AI-FanGe/AI_DesktopCat_Qwen3.5Omni/upload_facial_expression/README.md

# XIAO ESP32S3 全模块综合测试程序

## 📋 功能说明

这是一个综合测试固件，用于验证所有模块的功能。

---

## 🎬 新功能：动画播放

支持从8MB Flash读取JPEG序列帧动画并播放到屏幕上。使用PSRAM进行缓存。

### 动画文件说明
| 文件夹 | 帧数 | 文件名格式 |
|---|---|---|
| `anim1/` | 182帧 | 0001.jpg - 0182.jpg |
| `anim2/` | 35帧 | 0001.jpg - 0035.jpg |
| `anim3/` | 166帧 | 0001.jpg - 0166.jpg |

### 动画播放命令

| 命令 | 功能 |
|---|---|
| `a1` | 播放动画1 (182帧) |
| `a2` | 播放动画2 (35帧) |
| `a3` | 播放动画3 (166帧) |
| `a0` | 停止动画 |
| `al` | 切换循环模式 |

### ⚡ 上传动画数据到Flash

#### 方法1：使用Arduino IDE LittleFS插件（推荐）

1. **安装ESP32 LittleFS上传插件**
   - 下载插件：https://github.com/lorol/arduino-esp32littlefs-plugin/releases
   - 解压后将 `ESP32LittleFS` 文件夹放入 `Arduino/tools/` 目录
   - 最终路径应为：`Arduino/tools/ESP32LittleFS/tool/esp32littlefs.jar`
   - 重启Arduino IDE

2. **配置分区表**
   - Arduino IDE -> 工具 -> Partition Scheme
   - 选择 **"8M with spiffs (3MB APP/1.5MB SPIFFS)"**
   - 或选择自定义分区以获得更大存储空间

3. **准备data文件夹**
   - 确保 `data` 文件夹与 `test_all_modules.ino` 在同一目录
   ```
   test_all_modules/
   ├── test_all_modules.ino
   └── data/
       ├── anim1/
       │   ├── 0001.jpg
       │   ├── 0002.jpg
       │   └── ...
       ├── anim2/
       │   └── ...
       └── anim3/
           └── ...
   ```

4. **上传data文件夹**
   - Arduino IDE -> 工具 -> ESP32 Sketch Data Upload
   - 等待上传完成（可能需要几分钟）

#### 方法2：使用 esptool.py 命令行

```bash
# 1. 安装 mklittlefs 工具
# Windows: 从 https://github.com/earlephilhower/mklittlefs/releases 下载

# 2. 创建LittleFS镜像 (根据分区大小调整 -s 参数)
mklittlefs -c data -b 4096 -p 256 -s 3145728 littlefs.bin

# 3. 上传到ESP32S3 (根据实际COM端口和分区偏移地址修改)
esptool.py --chip esp32s3 --port COM3 --baud 921600 write_flash 0x290000 littlefs.bin
```

#### 方法3：使用 PlatformIO

在 `platformio.ini` 中配置：
```ini
[env:esp32s3]
platform = espressif32
board = seeed_xiao_esp32s3
framework = arduino
board_build.filesystem = littlefs
board_build.partitions = default_8MB.csv

# 启用PSRAM
build_flags = 
    -DBOARD_HAS_PSRAM
    -mfix-esp32-psram-cache-issue
```

然后运行：
```bash
pio run --target uploadfs
```

### 📚 需要安装的库

动画播放功能需要额外安装 **JPEGDEC** 库：
- Arduino IDE -> 工具 -> 管理库
- 搜索 `JPEGDEC` (作者: Larry Bank)
- 点击安装

### 🖼️ 图片格式要求

- 格式：JPEG
- 分辨率：建议 170x320 (与屏幕匹配) 或更小
- 单张大小：建议 < 60KB
- 命名：4位数字，如 0001.jpg, 0002.jpg

---

## 🔌 硬件连接

### 完整接线表

```
模块          引脚       ESP32S3
━━━━━━━━━━━━━━━━━━━━━━━━━━━━━
ST7789        CS      -> D0
屏幕          DC      -> D1
              RST     -> D2
              SDA     -> D10
              SCL     -> D8
              BL      -> VCC
              VCC     -> 3.3V
              GND     -> GND

PCA9685       SDA     -> D4
(I2C)         SCL     -> D5
              VCC     -> 3.3V或5V
              V+      -> 外部6V (舵机电源)
              GND     -> GND

MAX98357A     BCLK    -> D11 (底部焊盘)
(I2S音频)     LRC     -> D12 (底部焊盘)
              DIN     -> D9
              VCC     -> 5V
              GND     -> GND

URT-1         TX      -> D6
(总线舵机)    RX      -> D7
              VCC     -> 外部6-12V
              GND     -> GND
```

### ⚠️ 重要提示

1. **底部焊盘 D11/D12**
   - 需要在电路板背面焊接引线
   - 这两个引脚对应 GPIO42/GPIO41
   - 不与摄像头冲突

2. **电源共地**
   - 所有模块的 GND 必须连接在一起
   - PCA9685 的 V+ 使用外部电源（舵机供电）
   - URT-1 使用外部电源（总线舵机供电）

3. **URT-1 舵机 ID**
   - 测试前需将三个总线舵机 ID 分别设置为 **1、2、3**
   - 或修改代码中的 ID 号

## 🚀 使用方法

### 1. 上传程序

```bash
1. Arduino IDE 中打开 test_all_modules.ino
2. 选择板子: XIAO_ESP32S3
3. 选择端口
4. 点击上传
```

### 2. 打开串口监视器

```
波特率: 115200
```

### 3. 测试命令

在串口监视器中输入数字：

| 命令 | 功能 | 说明 |
|---|---|---|
| **1** | 屏幕测试 | 红→绿→蓝循环，每秒切换 |
| **2** | PCA9685测试 | 0和1号舵机交替旋转 |
| **3** | 音频测试 | 播放三个音调 (A-C-E) |
| **4** | URT-1测试 | 1/2/3号舵机同时来回旋转 |
| **5** | 全部测试 | 所有功能同时运行 |
| **0** | 停止 | 停止所有测试 |

## 📊 测试项目详情

### 测试1: 屏幕 (ST7789)

**测试内容:**
- 全屏填充红色 (1秒)
- 全屏填充绿色 (1秒)
- 全屏填充蓝色 (1秒)
- 循环

**通过标准:**
- ✓ 屏幕清晰显示三种颜色
- ✓ 颜色纯正无杂色
- ✓ 切换流畅无闪烁

### 测试2: PCA9685 舵机驱动

**测试内容:**
- 0号舵机：0° ↔ 90° 交替
- 1号舵机：90° ↔ 0° 交替
- 每秒切换一次

**通过标准:**
- ✓ 两个舵机都能旋转
- ✓ 角度准确
- ✓ 运动平滑

**连接舵机:**
```
舵机信号线 -> PCA9685 PWM0/PWM1
舵机电源 -> V+ (外部6V)
舵机GND -> GND
```

### 测试3: MAX98357A 音频

**测试内容:**
- 播放 440Hz 音调 (A音，200ms)
- 播放 523Hz 音调 (C音，200ms)  
- 播放 659Hz 音调 (E音，200ms)

**通过标准:**
- ✓ 能听到三个清晰的音调
- ✓ 音调不同（低→中→高）
- ✓ 无杂音或爆音

**连接扬声器:**
```
MAX98357A -> 扬声器
+  -> 扬声器+
-  -> 扬声器-
```

### 测试4: URT-1 总线舵机

**测试内容:**
- ID为1、2、3的三个舵机同时移动到位置500（约60°）
- 等待2秒
- 三个舵机同时移动到位置200（约24°）
- 等待2秒
- 循环

**通过标准:**
- ✓ 三个舵机都能收到命令
- ✓ 舵机同步来回旋转
- ✓ 位置准确

**舵机设置:**
- 使用 LX-16A 或兼容的总线舵机
- 将三个舵机 ID 分别设置为 **1、2、3**
- 或修改代码中的 ID

### 测试5: 全部同时运行

**测试内容:**
- 屏幕颜色循环（每1秒）
- PCA舵机交替（每1秒）
- 音频嘀嘀声（每3秒）
- URT-1舵机旋转（每2秒）

**通过标准:**
- ✓ 所有功能都能正常工作
- ✓ 没有相互干扰
- ✓ 系统稳定不死机

## 🔧 故障排除

### 问题1: 屏幕不显示

**检查:**
- CS, DC, RST, SDA, SCL 连接是否正确
- VCC 是否有 3.3V
- BL 背光是否接 VCC

**解决:**
- 参考之前的 test_basic.ino 测试

### 问题2: PCA9685 舵机不动

**检查:**
- I2C 连接 (SDA-D4, SCL-D5)
- V+ 外部电源是否连接（6V）
- 舵机信号线是否接对通道

**测试:**
- 串口应显示 "✓ PCA9685初始化完成"
- 舵机应该有"哒哒"声

### 问题3: 音频无声

**检查:**
- D11/D12 底部引脚是否焊接
- MAX98357A 电源是否正常
- 扬声器是否连接

**常见原因:**
- D11/D12 未焊接或接错
- GPIO编号不对（试试改为 42/41）

**修改代码测试:**
```cpp
// 如果没声音，尝试交换引脚
#define I2S_BCLK  41  // 改为41
#define I2S_LRC   42  // 改为42
```

### 问题4: URT-1 舵机不响应

**检查:**
- TX/RX 是否接反（常见错误）
- 舵机 ID 是否正确（必须是123）
- 舵机电源是否充足
- 波特率是否匹配（115200）

**测试舵机ID:**
- 使用 URT-1 配套的调试软件
- 确认舵机ID并修改代码

### 问题5: 编译错误

**缺少库:**
```
需要安装以下库：
- Adafruit GFX Library
- Adafruit ST7789
- Adafruit PWM Servo Driver Library
```

**安装方法:**
- Arduino IDE -> Tools -> Manage Libraries
- 搜索库名并安装

## 📝 修改舵机ID

### URT-1 总线舵机 ID

在代码中修改：

```cpp
// 第207-211行附近，修改舵机ID
urt1_moveServo(1, 500, 1000);  // 1改为你的第一个舵机ID
urt1_moveServo(2, 500, 1000);  // 2改为你的第二个舵机ID
urt1_moveServo(3, 500, 1000);  // 3改为你的第三个舵机ID
```

### PCA9685 舵机通道

在代码中修改：

```cpp
// 测试不同通道的舵机
pca.setPWM(0, 0, pulse0);  // 0改为其他通道 (0-15)
pca.setPWM(1, 0, pulse1);  // 1改为其他通道 (0-15)
```

## 💡 扩展功能

### 添加更多舵机

```cpp
// 在 testPCA9685() 函数中添加
pca.setPWM(2, 0, pulse);  // 通道2
pca.setPWM(3, 0, pulse);  // 通道3
// ... 最多16个通道
```

### 播放音乐

```cpp
// 修改 testAudio() 函数
generateTone(262, 200);  // C
generateTone(294, 200);  // D
generateTone(330, 200);  // E
generateTone(349, 200);  // F
generateTone(392, 200);  // G
generateTone(440, 200);  // A
generateTone(494, 200);  // B
```

### 屏幕显示文字

```cpp
tft.setCursor(10, 10);
tft.setTextColor(ST77XX_WHITE);
tft.setTextSize(2);
tft.println("Hello!");
```

## 🎯 预期输出

### 串口监视器输出示例

```
========================================
  XIAO ESP32S3 全模块测试程序
========================================
初始化屏幕...
✓ 屏幕初始化完成
初始化PCA9685...
✓ PCA9685初始化完成
初始化I2S音频...
✓ I2S音频初始化完成
初始化URT-1...
✓ URT-1初始化完成

========================================
所有模块初始化完成！
========================================
测试命令：
  1 - 测试屏幕（红绿蓝循环）
  2 - 测试PCA9685（0和1号舵机）
  3 - 测试音频（播放测试音）
  4 - 测试URT-1（1/2/3号舵机）
  5 - 全部同时测试
  0 - 停止测试
========================================

>>> 切换到测试模式: 1
测试模式1: 屏幕颜色循环

屏幕: 红色
屏幕: 绿色
屏幕: 蓝色
屏幕: 红色
...
```

## 📚 技术参考

### I2S 音频参数
- 采样率: 16kHz
- 位深度: 16bit
- 声道: 单声道

### PCA9685 参数
- PWM 频率: 50Hz
- 舵机范围: 150-600 (对应 0-180°)

### URT-1 协议
- 波特率: 115200
- 协议: LX-16A
- 位置范围: 0-1000

## ✅ 测试完成检查表

- [ ] 屏幕显示正常
- [ ] PCA9685 舵机运动正常
- [ ] 音频播放正常
- [ ] URT-1 舵机控制正常
- [ ] 所有功能可以同时运行
- [ ] 无死机或重启
- [ ] 所有模块不互相干扰

**全部通过？恭喜！硬件连接完全正确！** 🎉

---

**提示:** 如果某个功能不工作，可以单独测试该模块，更容易定位问题。
