AI-FanGe/AI_DesktopCat_Qwen3.5Omni/upload_facial_expression/修复说明_STS3032舵机.md

# STS3032舵机测试修复说明

## 🔍 问题原因

### 之前的代码（不工作）❌

```cpp
// 错误1：使用了LX-16A协议（手动实现）
void urt1_moveServo(uint8_t id, uint16_t position, uint16_t time) {
  // LX-16A 协议格式
  uint8_t buf[10];
  buf[0] = 0x55;
  buf[1] = 0x55;
  // ...
}

// 错误2：波特率115200
URT1Serial.begin(115200, SERIAL_8N1, URT1_RX, URT1_TX);
```

**问题：**
1. **协议不匹配**：STS3032使用的是飞特(Feetech)的STS协议，不是LX-16A协议
2. **波特率错误**：STS3032默认波特率是1000000 (1Mbps)，不是115200
3. **命令格式不同**：两种协议的数据包格式完全不同

### 现在的代码（能工作）✅

```cpp
// 正确1：使用SCServo库
#include <SCServo.h>
SMS_STS sts;

// 正确2：波特率1000000
#define STS_BAUD 1000000
Serial1.begin(STS_BAUD, SERIAL_8N1, STS_RX, STS_TX);
sts.pSerial = &Serial1;

// 正确3：使用库函数
sts.WritePosEx(1, 500, 1000, 50);  // 位置500, 时间1000ms, 加速度50
```

## 📝 主要修改

### 1. 添加SCServo库
```cpp
#include <SCServo.h>  // STS3032舵机库
```

### 2. 更改对象定义
```cpp
// 旧：HardwareSerial URT1Serial(1);
// 新：SMS_STS sts;
```

### 3. 修改波特率
```cpp
#define STS_BAUD 1000000  // 从115200改为1000000
```

### 4. 重写测试函数
```cpp
void testSTS3032() {
  if (millis() - lastUpdate > 2000) {
    lastUpdate = millis();
    
    if (servoDirection) {
      sts.WritePosEx(1, 500, 1000, 50);   // 使用库函数
      delay(20);
      sts.WritePosEx(2, 500, 1000, 50);
      delay(20);
      sts.WritePosEx(3, 500, 1000, 50);
      Serial.println("STS3032: 舵机1/2/3 -> 位置500");
    } else {
      sts.WritePosEx(1, 2500, 1000, 50);
      delay(20);
      sts.WritePosEx(2, 2500, 1000, 50);
      delay(20);
      sts.WritePosEx(3, 2500, 1000, 50);
      Serial.println("STS3032: 舵机1/2/3 -> 位置2500");
    }
    
    servoDirection = !servoDirection;
  }
}
```

### 5. 改进初始化（添加舵机检测）
```cpp
// 初始化STS3032舵机
Serial.println("初始化STS3032舵机...");
Serial1.begin(STS_BAUD, SERIAL_8N1, STS_RX, STS_TX);
delay(100);
sts.pSerial = &Serial1;

// 测试舵机连接
bool servoFound = false;
for (int id = 1; id <= 3; id++) {
  if (sts.Ping(id) != -1) {
    Serial.print("  ✓ 找到舵机ID: ");
    Serial.println(id);
    servoFound = true;
    // 启用扭矩
    sts.EnableTorque(id, 1);
    delay(10);
  }
}

if (servoFound) {
  Serial.println("✓ STS3032舵机初始化完成");
} else {
  Serial.println("⚠️  未找到STS3032舵机 (测试4将跳过)");
}
```

## 🔄 协议对比

### LX-16A协议（错误）
```
数据包：0x55 0x55 ID LEN CMD POS_L POS_H TIME_L TIME_H CHECKSUM
波特率：115200
位置范围：0-1000
```

### STS协议（正确）
```
使用SCServo库封装
波特率：1000000
位置范围：0-4095
命令：通过库函数调用，无需手动组包
```

## ✅ 验证测试

### 现在应该能看到：

1. **启动时**：
```
初始化STS3032舵机...
  ✓ 找到舵机ID: 1
  ✓ 找到舵机ID: 2
  ✓ 找到舵机ID: 3
✓ STS3032舵机初始化完成
```

2. **运行测试4**：
```
测试模式4: STS3032舵机

STS3032: 舵机1/2/3 -> 位置500
(舵机开始转动)
等待2秒...
STS3032: 舵机1/2/3 -> 位置2500
(舵机转到另一个位置)
```

## 📊 测试位置说明

| 位置值 | 角度（约） | 说明 |
|---|---|---|
| 500 | 约33° | 较小角度 |
| 2048 | 约135° | 中间位置 |
| 2500 | 约165° | 较大角度 |

STS3032的位置范围是0-4095，对应270°旋转角度。

## 🎯 使用说明

1. **上传修改后的代码**到ESP32S3
2. **打开串口监视器**（波特率115200）
3. **输入4**测试STS3032舵机
4. **观察舵机**应该每2秒来回转动

## 🔧 如果还是不工作

### 检查清单：
- [ ] SCServo库已安装
- [ ] 舵机供电充足（6-12V，至少1A）
- [ ] 接线正确（TX→43, RX→44）
- [ ] GND共地
- [ ] 舵机ID确实是1、2、3（使用set_servo_id工具确认）
- [ ] 启动时能看到"找到舵机ID"的信息

### 调试命令：
```cpp
// 在setup()后添加调试代码
Serial.println("测试Ping舵机...");
for (int id = 1; id <= 3; id++) {
  int result = sts.Ping(id);
  Serial.print("舵机");
  Serial.print(id);
  Serial.print(": ");
  Serial.println(result == -1 ? "离线" : "在线");
}
```

## 💡 关键点总结

1. **STS3032 ≠ LX-16A**：不同的协议，不能混用
2. **必须使用SCServo库**：不能手动实现协议
3. **波特率必须是1000000**：这是STS3032的默认值
4. **set_servo_id能工作**：证明硬件连接没问题，只是协议不对

---

**修复完成！现在test_all_modules应该能正常控制STS3032舵机了。** 🎉
