AI-FanGe/AI_DesktopCat_Qwen3.5Omni/upload_facial_expression/integrated/EMOTION_ANIM_MAP.md

# 情绪 → 表情动画映射

## 动画编号与含义

| anim | 名称 | 用途 |
|---|---|---|
| 1 | idle1 | 待机1 |
| 2 | idle2 | 待机2 |
| 3 | idle3 | 待机3 |
| 4 | cry | 哭 |
| 5 | angry | 生气 |
| 6 | happy | 开心 |
| 7 | sad | 难过 |
| 8 | shy | 害羞 |

## 情绪 → 表情 映射（server + ESP32）

| 情绪 | anim | 说明 |
|---|---|---|
| happy | 6 | 开心 → 开心 |
| sad | 7 | 难过 → 难过 |
| angry | 5 | 生气 → 生气 |
| fear | 4 | 害怕 → 哭 |
| love, shy | 8 | 喜爱、害羞 → 害羞 |
| surprised, excited | 6 | 惊讶、兴奋 → 开心 |
| thinking, sleepy, confused, neutral | 1~3 随机 | 思考/困倦/困惑/中性 → 随机待机 |

映射逻辑合理：强情绪有明确对应，中性/模糊情绪用待机。
