AI-FanGe/AI_DesktopCat_Qwen3.5Omni/esp32_servo_control/server/records/20260421-224106/1776836807018_0001.jpg

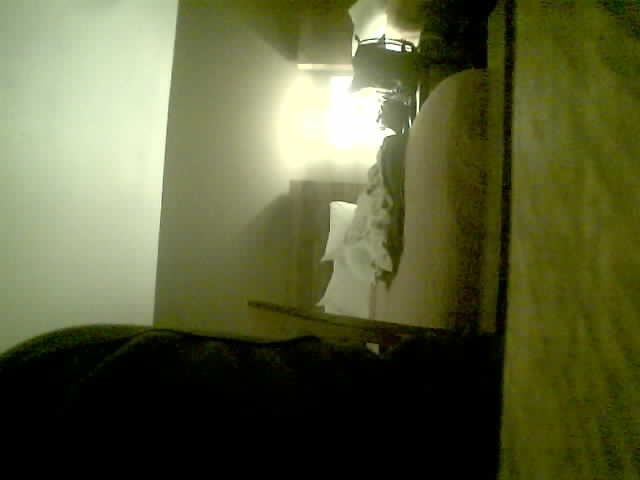
esp32_servo_control/server/records/20260421-224106/1776836807018_0001.jpg
