AI-FanGe/AI_DesktopCat_Qwen3.5Omni/esp32_servo_control/server/records/20260422-021050/1776849050138_0001.jpg

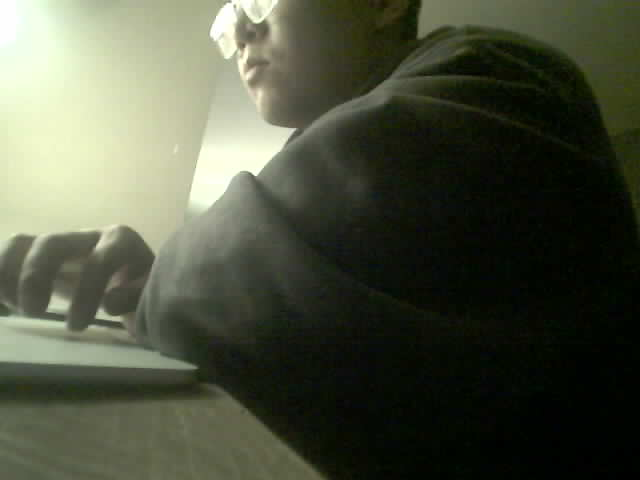
esp32_servo_control/server/records/20260422-021050/1776849050138_0001.jpg
