AI-FanGe/AI_DesktopCat_Qwen3.5Omni/esp32_servo_control/server/records/20260423-064922/1776952162341_0001.jpg

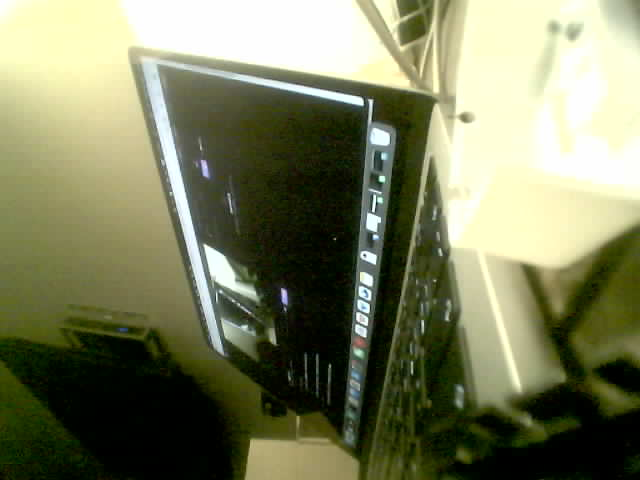
esp32_servo_control/server/records/20260423-064922/1776952162341_0001.jpg
