AI-FanGe/AI_DesktopCat_Qwen3.5Omni/esp32_servo_control/server/records/20260426-100640/1777219600653_0001.jpg

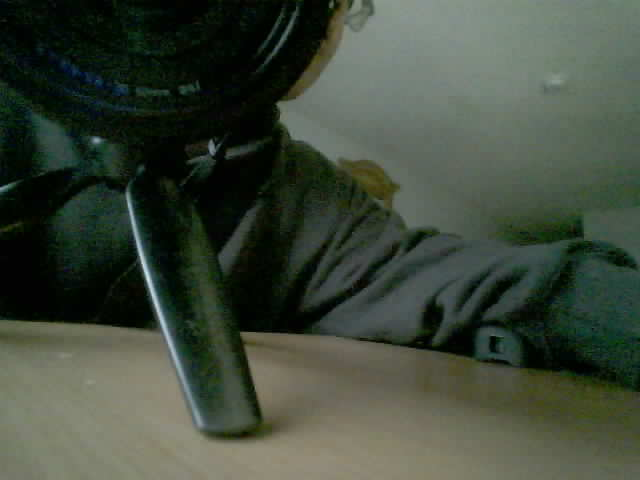
esp32_servo_control/server/records/20260426-100640/1777219600653_0001.jpg
